hnaderi/drsstc/gallery/tondar-khan-thumbnail.png

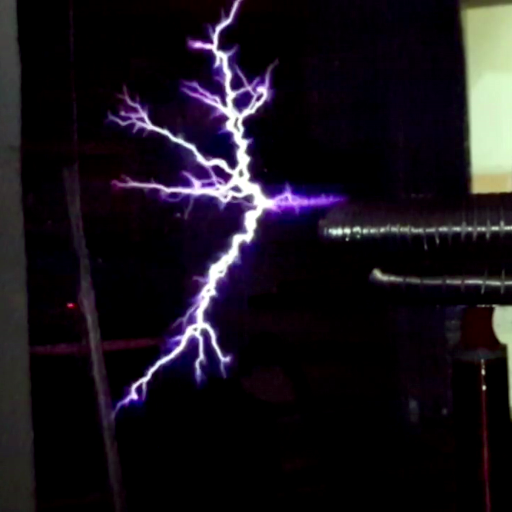
gallery/tondar-khan-thumbnail.png
