hnaderi/drsstc/parts/toslink-connector-opl530-led.FCStd

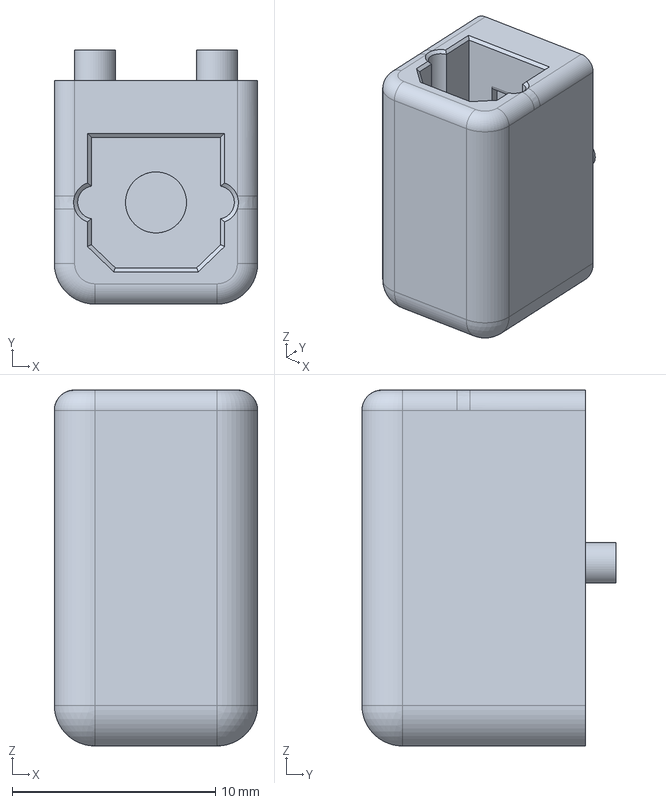
[picture p2: CAD file, 2026-04-13]
parts/toslink-connector-opl530-led.FCStd
10.0 x 12.5 x 17.5 mm
