hnaderi/drsstc/parts/primary-new.FCStd

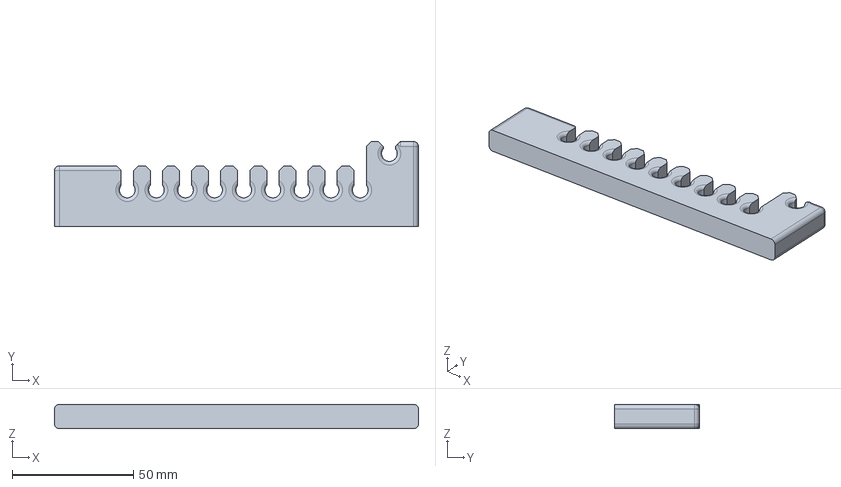
[picture p3: CAD file, 2026-01-07]
parts/primary-new.FCStd
150.0 x 35.0 x 10.0 mm
