hnaderi/drsstc/parts/secondary-cap.FCStd

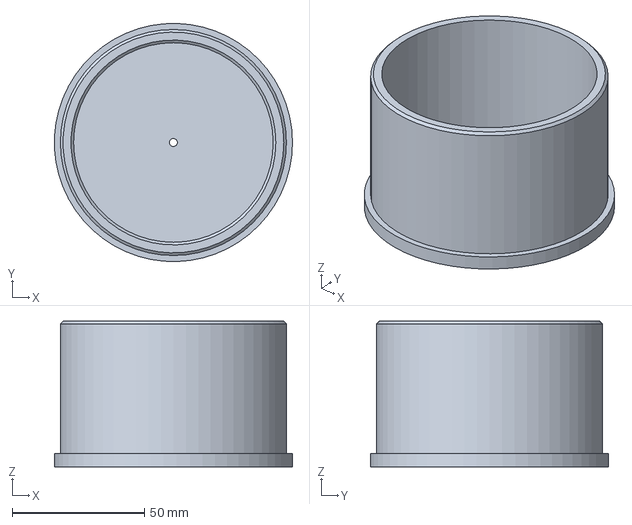
[picture p4: CAD file, 2026-01-07]
parts/secondary-cap.FCStd
89.9 x 90.0 x 55.0 mm
