hnaderi/drsstc/parts/toslink-connector.FCStd

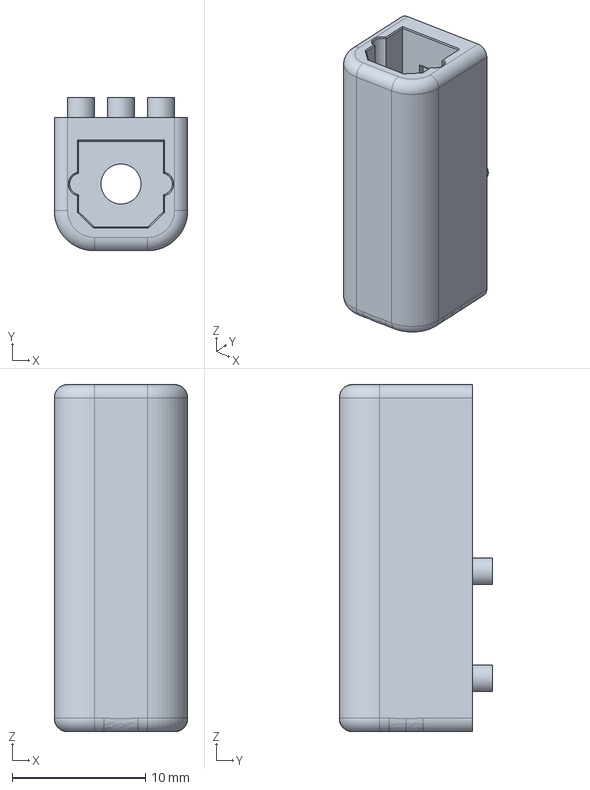
[picture p5: CAD file, 2025-07-24]
parts/toslink-connector.FCStd
10.0 x 11.5 x 26.0 mm
