hnaderi/drsstc/parts/drsstc-I.FCStd

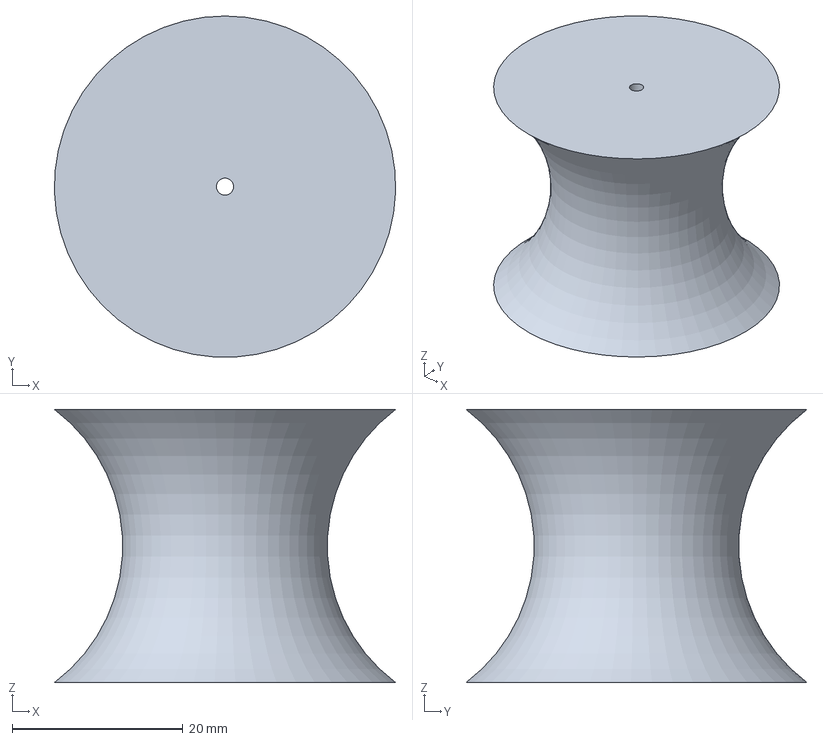
[picture p6: CAD file, 2025-07-23]
parts/drsstc-I.FCStd
40.0 x 40.0 x 32.0 mm
