hnaderi/drsstc/parts/toroid.FCStd

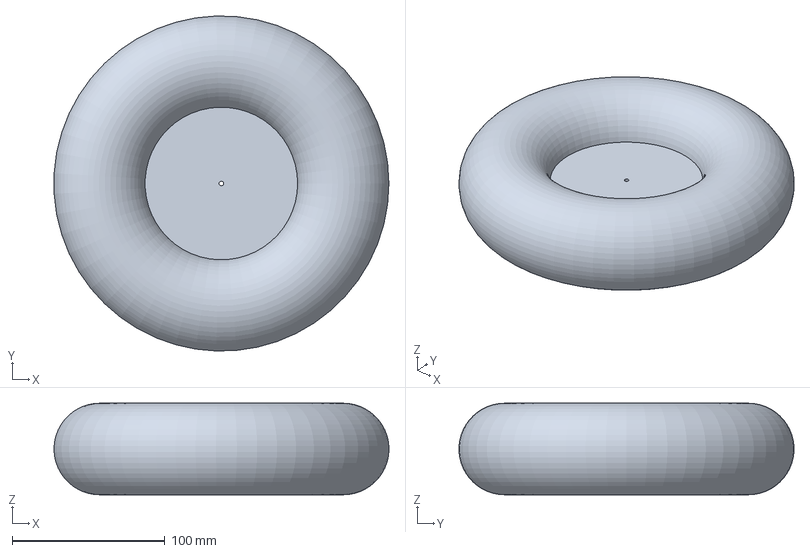
[picture p7: CAD file, 2025-07-23]
parts/toroid.FCStd
219.5 x 219.6 x 60.0 mm
