hnaderi/drsstc/driver/driver.kicad_pcb

## KiCad design driver/driver.kicad_pcb (2026-01-24)

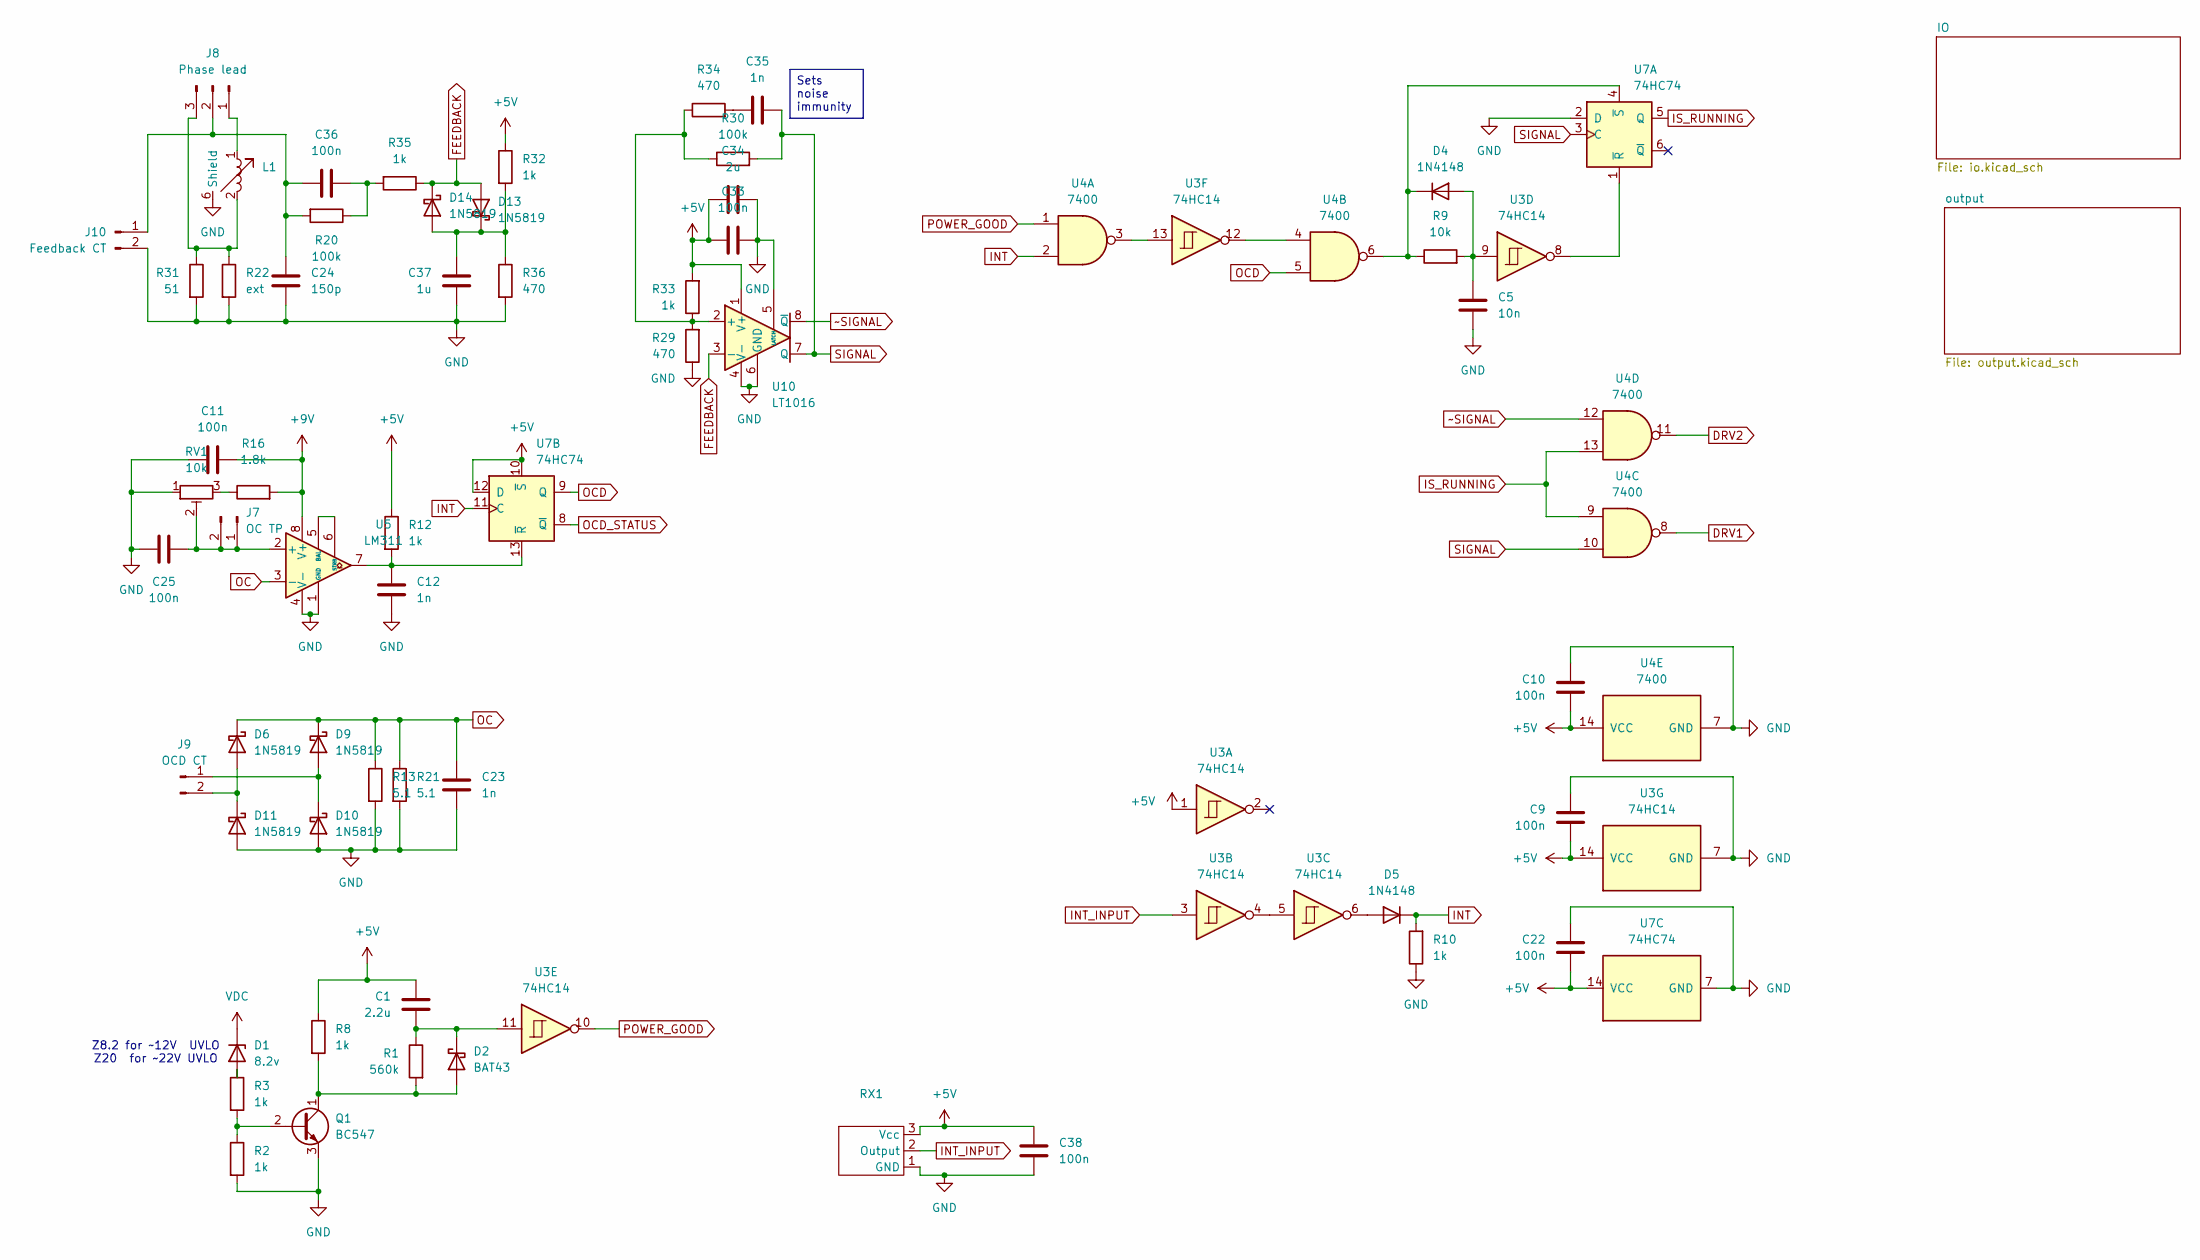
[picture p8: schematic driver.kicad_sch, hnaderi's DRSSTC II]

Parts:
C1: 2.2u; C_Disc_D4.7mm_W2.5mm_P5.00mm
C5: 10n; C_Disc_D4.7mm_W2.5mm_P5.00mm
C9, C10, C11, C22, C25, C33, C36, C38: 100n; C_Disc_D4.7mm_W2.5mm_P5.00mm
C12, C23, C35: 1n; C_Disc_D4.7mm_W2.5mm_P5.00mm
C24: 150p; C_Disc_D4.7mm_W2.5mm_P5.00mm
C34: 2u; C_Rect_L7.2mm_W7.2mm_P5.00mm_FKS2_FKP2_MKS2_MKP2
C37: 1u; C_Disc_D4.7mm_W2.5mm_P5.00mm
D1: 8.2v; D_DO-35_SOD27_P2.54mm_Vertical_KathodeUp
D2: BAT43; D_DO-35_SOD27_P2.54mm_Vertical_KathodeUp
D4, D5: 1N4148; D_DO-35_SOD27_P2.54mm_Vertical_KathodeUp
D6, D9, D10, D11, D13, D14: 1N5819; D_DO-41_SOD81_P2.54mm_Vertical_KathodeUp
J7: OC TP; PinHeader_1x02_P2.54mm_Vertical
J8: Phase lead; PinHeader_1x03_P2.54mm_Vertical
J9: OCD CT; JST_XH_B2B-XH-A_1x02_P2.50mm_Vertical
J10: Feedback CT; JST_XH_B2B-XH-A_1x02_P2.50mm_Vertical
L1: universal tunable inductor
Q1: BC547; TO-92_Inline_Wide
R1: 560k; R_Axial_DIN0207_L6.3mm_D2.5mm_P2.54mm_Vertical
R2, R3, R8, R10, R12, R32, R33: 1k; R_Axial_DIN0207_L6.3mm_D2.5mm_P2.54mm_Vertical
R9: 10k; R_Axial_DIN0207_L6.3mm_D2.5mm_P2.54mm_Vertical
R13, R21: 5.1; R_Axial_DIN0207_L6.3mm_D2.5mm_P2.54mm_Vertical
R16: 1.8k; R_Axial_DIN0207_L6.3mm_D2.5mm_P2.54mm_Vertical
R20: 100k; R_Axial_DIN0309_L9.0mm_D3.2mm_P2.54mm_Vertical
R22: ext; R_Axial_DIN0309_L9.0mm_D3.2mm_P2.54mm_Vertical
R29, R34, R36: 470; R_Axial_DIN0207_L6.3mm_D2.5mm_P2.54mm_Vertical
R30: 100k; R_Axial_DIN0207_L6.3mm_D2.5mm_P2.54mm_Vertical
R31: 51; R_Axial_DIN0309_L9.0mm_D3.2mm_P2.54mm_Vertical
R35: 1k; R_Axial_DIN0309_L9.0mm_D3.2mm_P2.54mm_Vertical
RV1: 10k; Potentiometer_Bourns_3296W_Vertical
RX1: hnaderi-opl530-rx
U3: 74HC14; DIP-14_W7.62mm
U4: 7400; DIP-14_W7.62mm
U5: LM311; DIP-8_W7.62mm
U7: 74HC74; DIP-14_W7.62mm
U10: LT1016; DIP-8_W7.62mm

Connections:
+5V: C1.2, C9.2, C10.2, C22.2, C33.2, C34.2, C38.1, R8.1, R12.1, R32.1, R33.2, RX1.3 (Vcc), U3.1, U3.14 (VCC), U4.14 (VCC), U7.10 (~S), U7.12 (D), U7.14 (VCC), U10.1 (V+); also elsewhere on the board
+9V: C11.2, R16.2, U5.8 (V+); also elsewhere on the board
DRV1: U4.8; also elsewhere on the board
DRV2: U4.11; also elsewhere on the board
FEEDBACK: D13.2 (A), D14.1 (K), R35.1, U10.3 (-); also elsewhere on the board
GND: C5.2, C9.1, C10.1, C11.1, C12.2, C22.1, C23.2, C24.1, C25.1, C33.1, C34.1, C37.2, C38.2, D10.2 (A), D11.2 (A), J10.2, L1.6 (Shield), Q1.3 (E), R2.2, R10.1, R13.2, R21.2, R22.2, R29.1, R31.2, R36.2, RV1.1, RX1.1 (GND), U3.7 (GND), U4.7 (GND), U5.1 (GND), U5.4 (V-), U7.2 (D), U7.7 (GND), U10.4 (V-), U10.5 (LATCH), U10.6 (GND); also elsewhere on the board
INT: D5.1 (K), R10.2, U4.2, U7.11 (C); also elsewhere on the board
INT_INPUT: RX1.2 (Output), U3.3; also elsewhere on the board
IS_RUNNING: U4.9, U4.13, U7.5 (Q)
unnamed: C35.2, R34.2
unnamed: C36.1, R20.1, R35.2
unnamed: D1.2 (A), R3.1
unnamed: D2.2 (A), Q1.1 (C), R1.2, R8.2
unnamed: C1.1, D2.1 (K), R1.1, U3.11
unnamed: C5.1, D4.2 (A), R9.2, U3.9
unnamed: D4.1 (K), R9.1, U4.6, U7.4 (~S)
unnamed: D5.2 (A), U3.6
unnamed: D9.2 (A), D10.1 (K), J9.1
unnamed: D6.2 (A), D11.1 (K), J9.2
unnamed: C37.1, D13.1 (K), D14.2 (A), R32.2, R36.1
unnamed: C25.2, J7.1, J7.2, RV1.2, U5.2 (+)
unnamed: J8.1, L1.1
unnamed: J8.3, L1.2, R22.1, R31.1
unnamed: C24.2, C36.2, J8.2, J10.1, R20.2
unnamed: Q1.2 (B), R2.1, R3.2
unnamed: R16.1, RV1.3
unnamed: U3.4, U3.5
unnamed: U3.12, U4.4
unnamed: U3.13, U4.3
unnamed: U5.5 (BAL), U5.6 (STRB)
unnamed: U3.8, U7.1 (~R)
unnamed: C12.1, R12.2, U5.7, U7.13 (~R)
unnamed: R29.2, R30.1, R33.1, R34.1, U10.2 (+)
OC: C23.1, D6.1 (K), D9.1 (K), R13.1, R21.1, U5.3 (-)
OCD: U4.5, U7.9 (Q)
OCD_STATUS: U7.8 (~Q); also elsewhere on the board
POWER_GOOD: U3.10, U4.1; also elsewhere on the board
SIGNAL: C35.1, R30.2, U4.10, U7.3 (C), U10.7 (Q); also elsewhere on the board
VDC: D1.1 (K); also elsewhere on the board
~SIGNAL: U4.12, U10.8 (~Q)

Notes on the sheet:
Z8.2 for ~12V UVLO Z20 for ~22V UVLO
Sets noise immunity

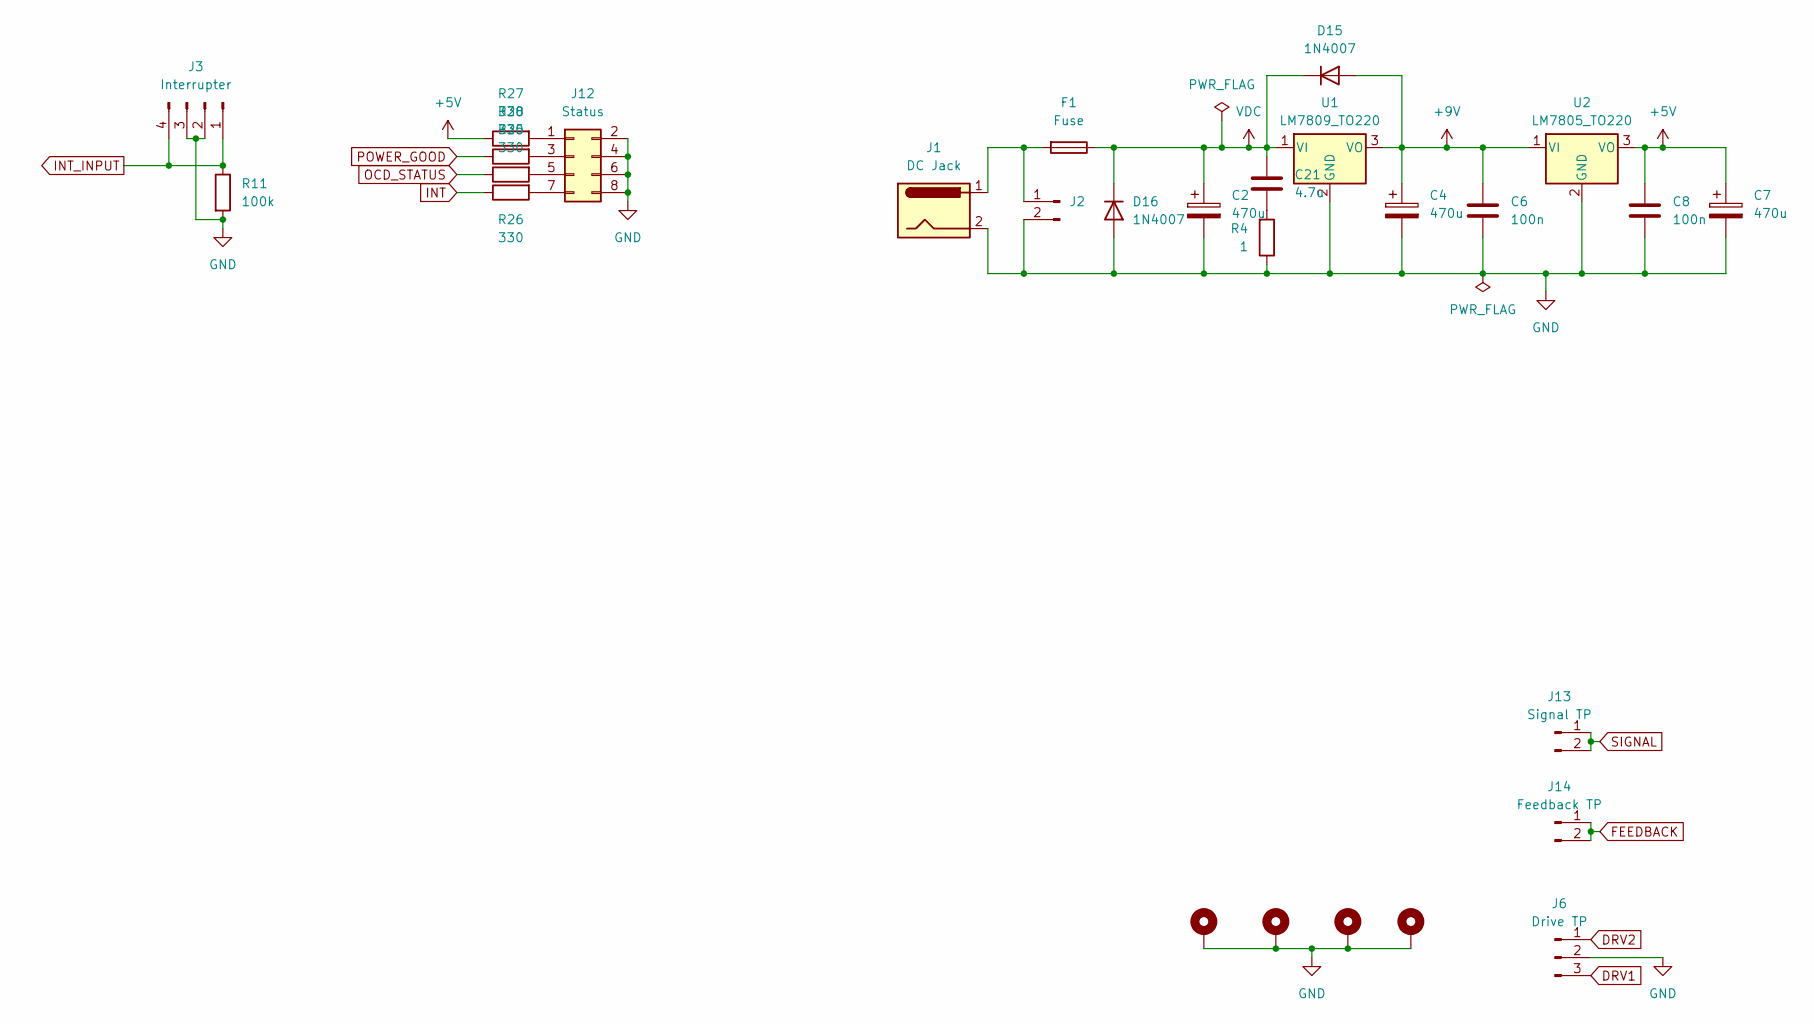
[picture p9: schematic io.kicad_sch, hnaderi's DRSSTC II]

Parts:
C2, C4, C7: 470u; CP_Radial_D10.0mm_P5.00mm
C6, C8: 100n; C_Disc_D4.7mm_W2.5mm_P5.00mm
C21: 4.7u; C_Disc_D4.7mm_W2.5mm_P5.00mm
D15, D16: 1N4007; D_DO-35_SOD27_P2.54mm_Vertical_KathodeUp
F1: Fuse; Fuse_Littelfuse_395Series
H1, H2, H3, H4: Body; MountingHole_3.2mm_M3_DIN965_Pad_TopBottom
J1: DC Jack; BarrelJack_Horizontal
J2: JST_XH_B2B-XH-A_1x02_P2.50mm_Vertical
J3: Interrupter; PinHeader_1x04_P2.54mm_Vertical
J6: Drive TP; PinHeader_1x03_P2.54mm_Vertical
J12: Status; PinHeader_2x04_P2.54mm_Vertical
J13: Signal TP; PinHeader_1x02_P2.54mm_Vertical
J14: Feedback TP; PinHeader_1x02_P2.54mm_Vertical
R4: 1; R_Axial_DIN0207_L6.3mm_D2.5mm_P2.54mm_Vertical
R11: 100k; R_Axial_DIN0207_L6.3mm_D2.5mm_P2.54mm_Vertical
R25, R26, R27, R28: 330; R_Axial_DIN0207_L6.3mm_D2.5mm_P2.54mm_Vertical
U1: LM7809_TO220; TO-220-3_Vertical
U2: LM7805_TO220; TO-220-3_Vertical

Connections:
+5V: C7.1, C8.1, R27.1, U2.3 (VO); also elsewhere on the board
+9V: C4.1, C6.1, D15.2 (A), U1.3 (VO), U2.1 (VI); also elsewhere on the board
DRV1: J6.3; also elsewhere on the board
DRV2: J6.1; also elsewhere on the board
FEEDBACK: J14.1, J14.2; also elsewhere on the board
GND: C2.2, C4.2, C6.2, C7.2, C8.2, D16.2 (A), H1.1, H2.1, H3.1, H4.1, J1.2, J2.2, J3.2, J3.3, J6.2, J12.2, J12.4, J12.6, J12.8, R4.1, R11.2, U1.2 (GND), U2.2 (GND); also elsewhere on the board
INT: R26.1; also elsewhere on the board
INT_INPUT: J3.1, J3.4, R11.1; also elsewhere on the board
unnamed: C21.2, R4.2
unnamed: F1.2, J1.1, J2.1
unnamed: J12.1, R27.2
unnamed: J12.3, R28.2
unnamed: J12.5, R25.2
unnamed: J12.7, R26.2
OCD_STATUS: R25.1; also elsewhere on the board
POWER_GOOD: R28.1; also elsewhere on the board
SIGNAL: J13.1, J13.2; also elsewhere on the board
VDC: C2.1, C21.1, D15.1 (K), D16.1 (K), F1.1, U1.1 (VI); also elsewhere on the board

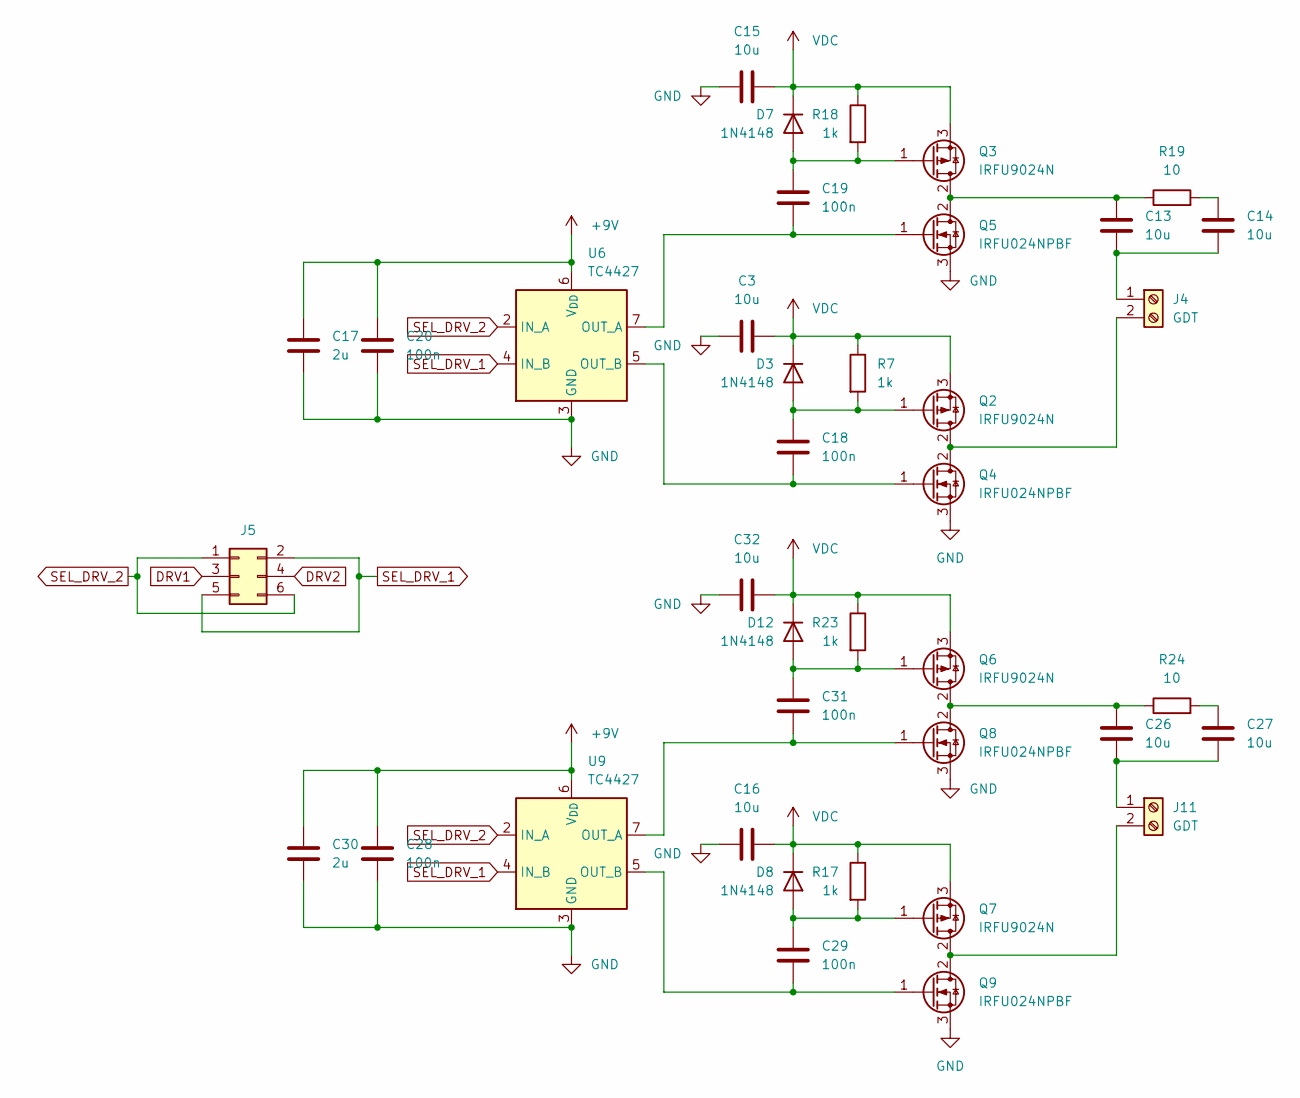
[picture p10: schematic output.kicad_sch, hnaderi's DRSSTC II]

Parts:
C3, C13, C14, C15, C16, C26, C27, C32: 10u; C_Disc_D4.7mm_W2.5mm_P5.00mm
C17, C30: 2u; C_Rect_L7.2mm_W7.2mm_P5.00mm_FKS2_FKP2_MKS2_MKP2
C18, C19, C20, C28, C29, C31: 100n; C_Disc_D4.7mm_W2.5mm_P5.00mm
D3, D7, D8, D12: 1N4148; D_DO-35_SOD27_P2.54mm_Vertical_KathodeUp
J4, J11: GDT; JST_XH_B2B-XH-A_1x02_P2.50mm_Vertical
J5: Conn_02x03_Odd_Even; PinHeader_2x03_P2.54mm_Vertical
Q2, Q3, Q6, Q7: IRFU9024N; TO-251-3-1EP_Horizontal_TabDown
Q4, Q5, Q8, Q9: IRFU024NPBF; TO-251-3-1EP_Horizontal_TabDown
R7, R17, R18, R23: 1k; R_Axial_DIN0207_L6.3mm_D2.5mm_P2.54mm_Vertical
R19, R24: 10; R_Axial_DIN0309_L9.0mm_D3.2mm_P2.54mm_Vertical
U6, U9: TC4427; DIP-8_W7.62mm

Connections:
+9V: C17.2, C20.2, C28.2, C30.2, U6.6 (V_{DD}), U9.6 (V_{DD}); also elsewhere on the board
DRV1: J5.3; also elsewhere on the board
DRV2: J5.4; also elsewhere on the board
GND: C3.2, C15.2, C16.2, C17.1, C20.1, C28.1, C30.1, C32.2, Q4.3 (S), Q5.3 (S), Q8.3 (S), Q9.3 (S), U6.3 (GND), U9.3 (GND); also elsewhere on the board
unnamed: C14.1, R19.2
unnamed: C27.1, R24.2
unnamed: C18.1, D3.2 (A), Q2.1 (G), R7.2
unnamed: C19.1, D7.2 (A), Q3.1 (G), R18.2
unnamed: C29.1, D8.2 (A), Q7.1 (G), R17.2
unnamed: C31.1, D12.2 (A), Q6.1 (G), R23.2
unnamed: C13.2, C14.2, J4.1
unnamed: J4.2, Q2.2 (D), Q4.2 (D)
unnamed: C26.2, C27.2, J11.1
unnamed: J11.2, Q7.2 (D), Q9.2 (D)
unnamed: C13.1, Q3.2 (D), Q5.2 (D), R19.1
unnamed: C18.2, Q4.1 (G), U6.5 (OUT_B)
unnamed: C19.2, Q5.1 (G), U6.7 (OUT_A)
unnamed: C26.1, Q6.2 (D), Q8.2 (D), R24.1
unnamed: C31.2, Q8.1 (G), U9.7 (OUT_A)
unnamed: C29.2, Q9.1 (G), U9.5 (OUT_B)
SEL_DRV_1: J5.2, J5.5, U6.4 (IN_B), U9.4 (IN_B)
SEL_DRV_2: J5.1, J5.6, U6.2 (IN_A), U9.2 (IN_A)
VDC: C3.1, C15.1, C16.1, C32.1, D3.1 (K), D7.1 (K), D8.1 (K), D12.1 (K), Q2.3 (S), Q3.3 (S), Q6.3 (S), Q7.3 (S), R7.1, R17.1, R18.1, R23.1; also elsewhere on the board

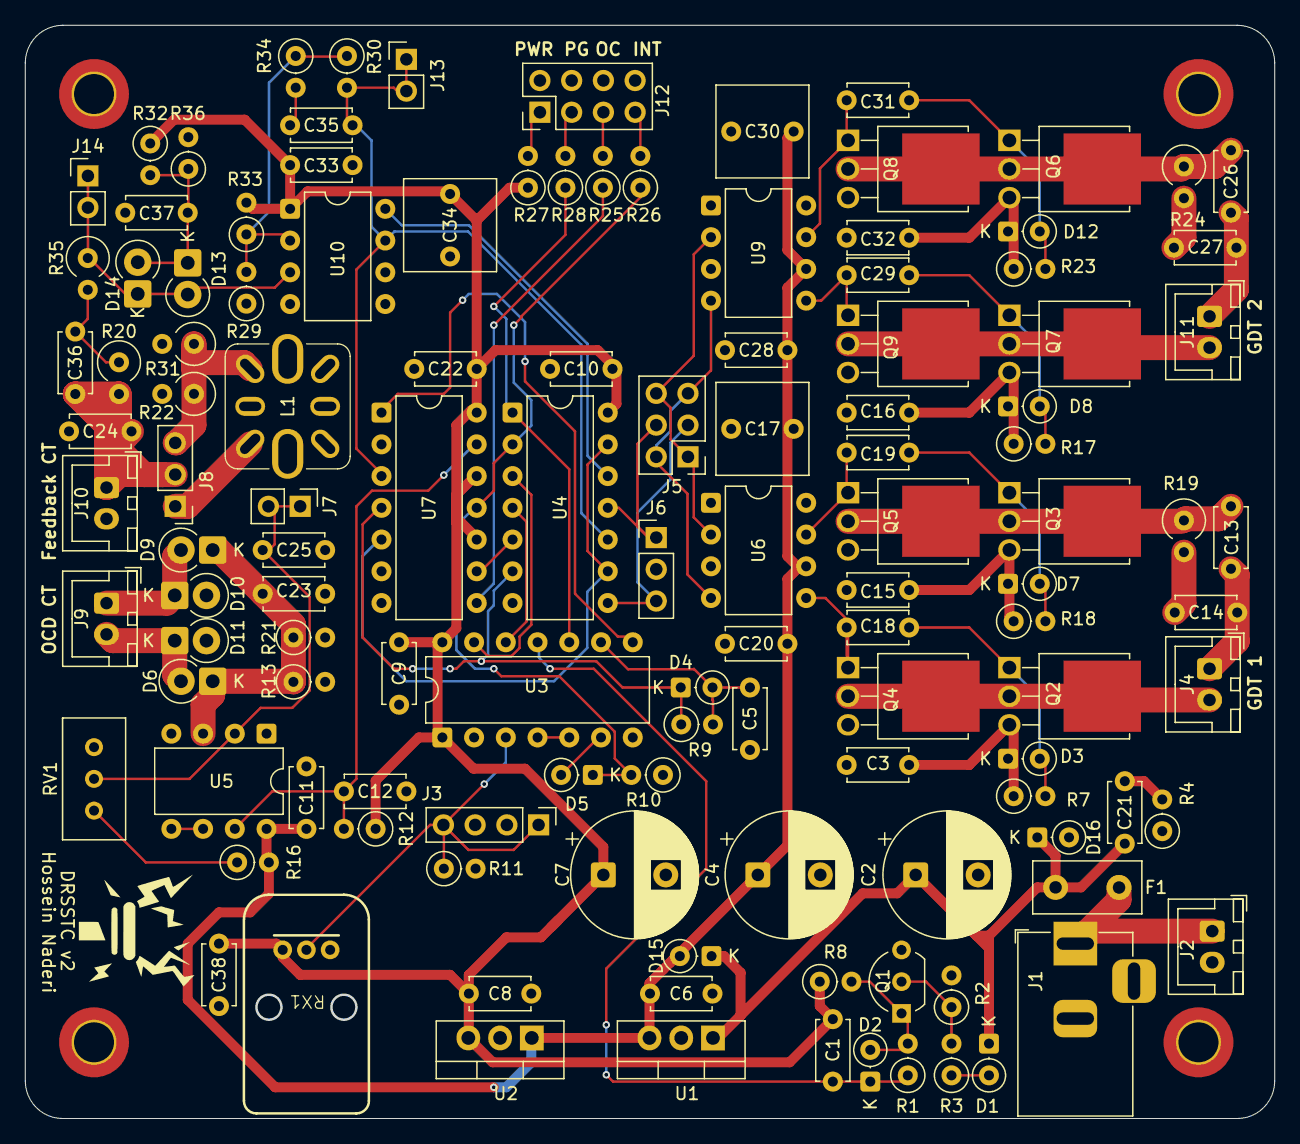
[picture p11: board driver.kicad_pcb from above]

Board: 2 copper layers, 100.0 x 87.5 mm, 126 parts (0 on the bottom side), 64 nets.
