hnaderi/drsstc/testing/bridge-vout-cout.png

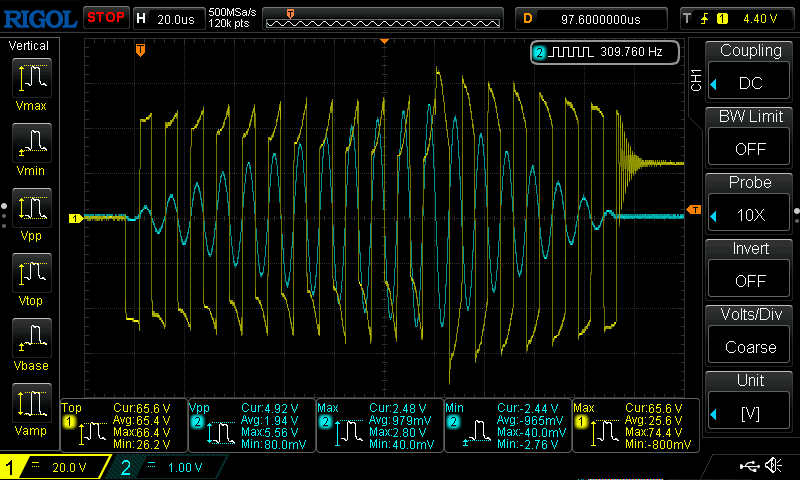
testing/bridge-vout-cout.png
