hnaderi/drsstc/(commit log)

2025-07-24 Toslink connector parts
    [toslink-connector.FCStd]
2025-07-24 Adjusted toslink connector parts
    [toslink-connector.FCStd]
2025-07-24 Added footprint for toslink rx module
    [io.kicad_sch, output.kicad_sch, ud-v2.10.kicad_pcb, ud-v2.10.kicad_sch]
2025-07-29 WIP: PCB layout
    [io.kicad_sch, output.kicad_sch, ud-v2.10.kicad_pcb, ud-v2.10.kicad_sch]
2025-07-30 Fixed wrong receiver diode pins
    [ud-v2.10.kicad_pcb]
2025-08-03 PCB draft
    [io.kicad_sch, output.kicad_sch, ud-v2.10.kicad_pcb, ud-v2.10.kicad_sch]
2025-08-11 WIP: PCB tracing
    [io.kicad_sch, output.kicad_sch, ud-v2.10.kicad_pcb, ud-v2.10.kicad_sch]
2025-08-14 Routed most of the remaining traces
    [io.kicad_sch, output.kicad_sch, ud-v2.10.kicad_pcb, ud-v2.10.kicad_sch]
2025-08-14 Duplicated GDT driver
    [output.kicad_sch, ud-v2.10.kicad_pcb]
2025-08-15 First completed revision
    [io.kicad_sch, output.kicad_sch, ud-v2.10.kicad_pcb, ud-v2.10.kicad_sch]
2025-08-16 Reannotated PCB
    [io.kicad_sch, output.kicad_sch, ud-v2.10.kicad_pcb, ud-v2.10.kicad_sch]
2025-08-16 Added fuse and more decoupling
    [io.kicad_sch, output.kicad_sch, ud-v2.10.kicad_pcb, ud-v2.10.kicad_sch]
2025-08-17 Added pull down resistor on interrupt
    [io.kicad_sch, output.kicad_sch, ud-v2.10.kicad_pcb, ud-v2.10.kicad_sch]
2025-08-17 Renamed to drsstc-v1
    [drsstc-v1.kicad_pcb, drsstc-v1.kicad_sch, io.kicad_sch, output.kicad_sch]
2025-08-17 Added opamp phase lead simulation
    [phase-lead-opamp.sch]
2025-08-17 Export fabrication outputs
    [drsstc-v1-B_Cu.gbr, drsstc-v1-B_Mask.gbr, drsstc-v1-B_Paste.gbr, drsstc-v1-B_Silkscreen.gbr, drsstc-v1-Edge_Cuts.gbr, drsstc-v1-F_Cu.gbr, drsstc-v1-F_Mask.gbr, drsstc-v1-F_Paste.gbr]
2025-10-03 Added secondary cap
    [secondary-cap.FCStd]
2026-01-07 Added my large drsstc parts
    [primary-new.FCStd, secondary-cap.FCStd]
2026-01-24 Fixed missing start up pulse
    [drsstc-v1-NPTH.drl, drsstc-v2-B_Cu.gbr, drsstc-v2-B_Mask.gbr, drsstc-v2-B_Paste.gbr, drsstc-v2-B_Silkscreen.gbr, drsstc-v2-Edge_Cuts.gbr, drsstc-v2-F_Cu.gbr, drsstc-v2-F_Mask.gbr]
2026-01-24 Renamed drsstc-v2 to driver
    [driver-B_Cu.gbr, driver-B_Mask.gbr, driver-B_Paste.gbr, driver-B_Silkscreen.gbr, driver-Edge_Cuts.gbr, driver-F_Cu.gbr, driver-F_Mask.gbr, driver-F_Paste.gbr]
2026-04-13 Latest working fiber connector part
    [toslink-connector-opl530-led.FCStd]
